sankisuguya-create/stl-box/README.md

# stl-box

3Dプリンタ（Bambu P1S）用STL置き場。

- [magnet-sphere/](magnet-sphere/) — 磁石で断面が吸着する分割球体（Ø150本番・Ø50モック・Ø200大版）
