sankisuguya-create/stl-box/magnet-sphere/sphere50/preview_hemisphere.png

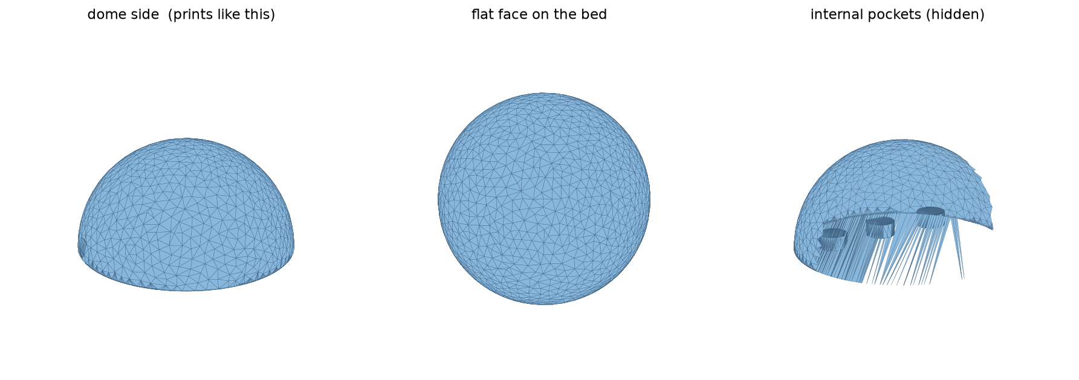
magnet-sphere/sphere50/preview_hemisphere.png
