sankisuguya-create/stl-box/magnet-sphere/sphere50/preview_layout.png

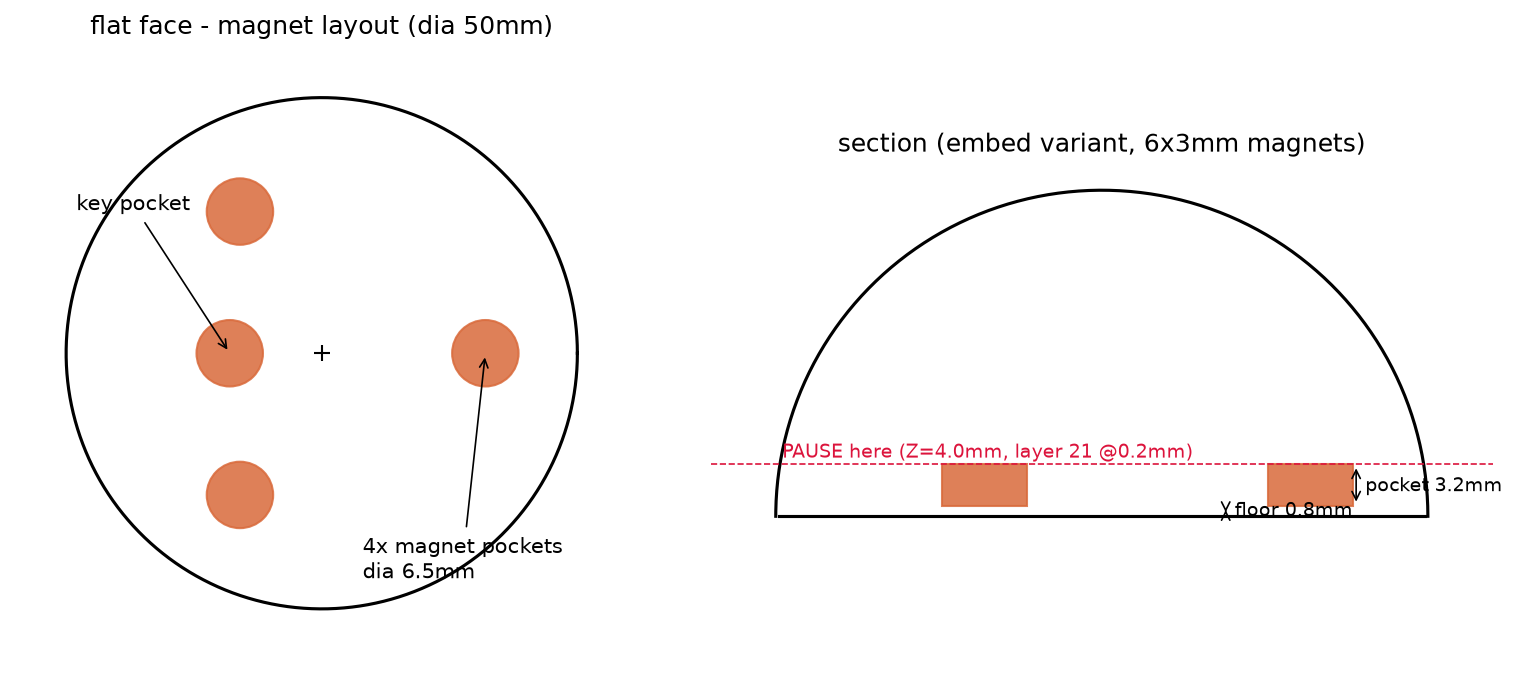
magnet-sphere/sphere50/preview_layout.png
