sankisuguya-create/stl-box/magnet-sphere/sphere150/preview150_exploded.png

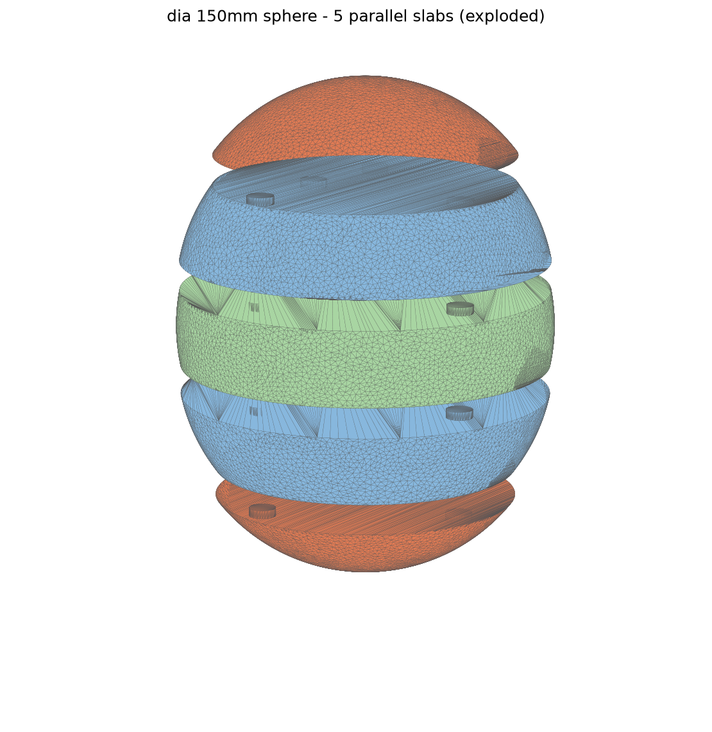
magnet-sphere/sphere150/preview150_exploded.png
