sankisuguya-create/stl-box/magnet-sphere/sphere150/sphere150_cap_m10x3_openface.stl

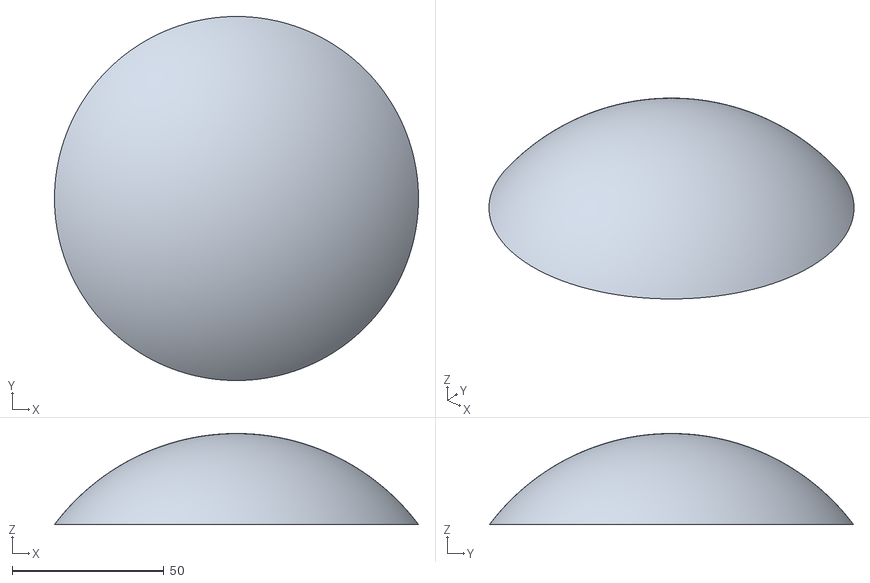
[picture p4: CAD file, 2026-10-11]
magnet-sphere/sphere150/sphere150_cap_m10x3_openface.stl
120.0 x 120.0 x 30.0
