sankisuguya-create/stl-box/magnet-sphere/sphere200/sphere200_cap_m10x3_openface.stl

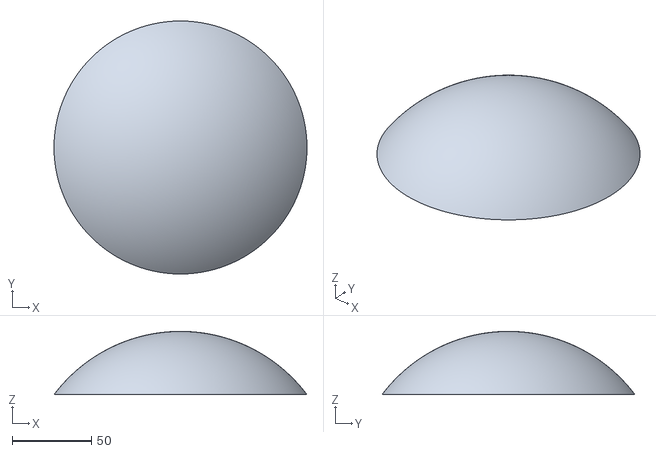
[picture p6: CAD file, 2026-10-11]
magnet-sphere/sphere200/sphere200_cap_m10x3_openface.stl
160.0 x 160.0 x 40.0
