sankisuguya-create/stl-box/magnet-sphere/sphere50/hemisphere50_m6x3_openface.stl

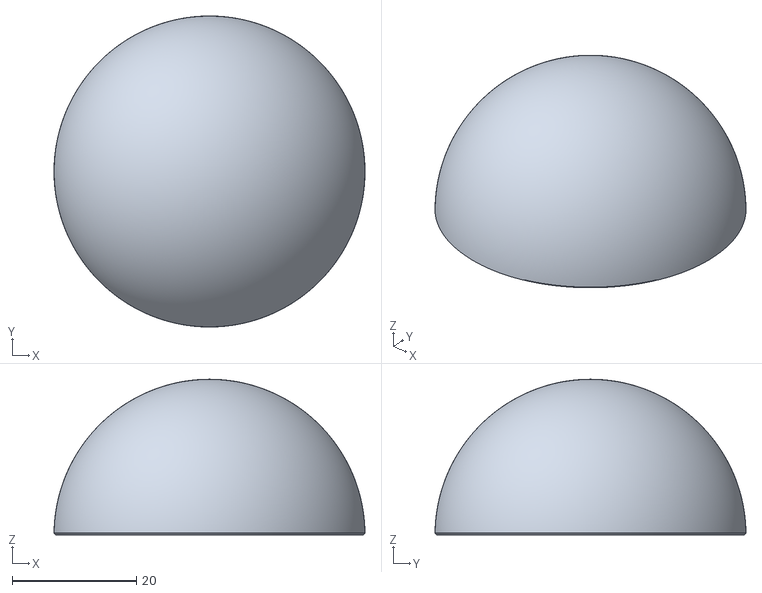
[picture p7: CAD file, 2026-10-11]
magnet-sphere/sphere50/hemisphere50_m6x3_openface.stl
50.0 x 50.0 x 25.0
