sankisuguya-create/stl-box/magnet-sphere/sphere150/sphere150_mid_slab_m10x3_embed.stl

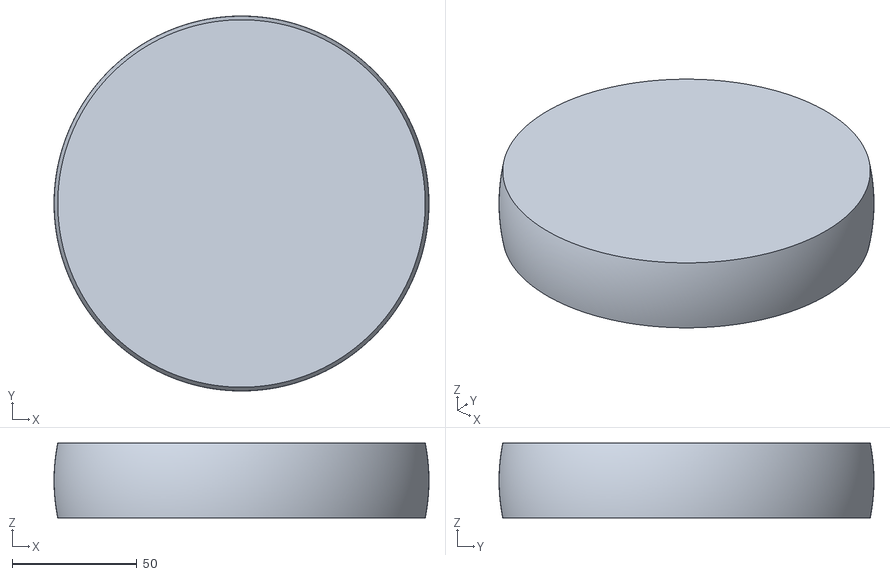
[picture p8: CAD file, 2026-10-11]
magnet-sphere/sphere150/sphere150_mid_slab_m10x3_embed.stl
150.0 x 150.0 x 30.0
