sankisuguya-create/stl-box/magnet-sphere/sphere150_cut5/sphere150cut5_P5_m10x3_embed.stl

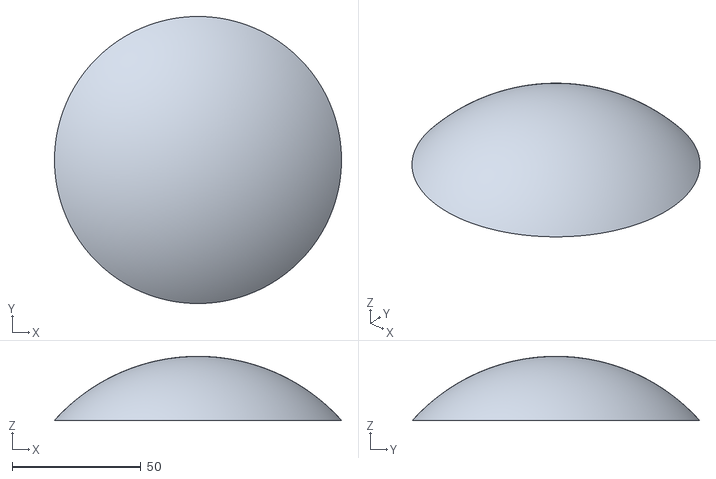
[picture p9: CAD file, 2026-10-11]
magnet-sphere/sphere150_cut5/sphere150cut5_P5_m10x3_embed.stl
111.5 x 111.5 x 25.0
