sankisuguya-create/stl-box/magnet-sphere/sphere200/sphere200_mid_slab_m10x3_embed.stl

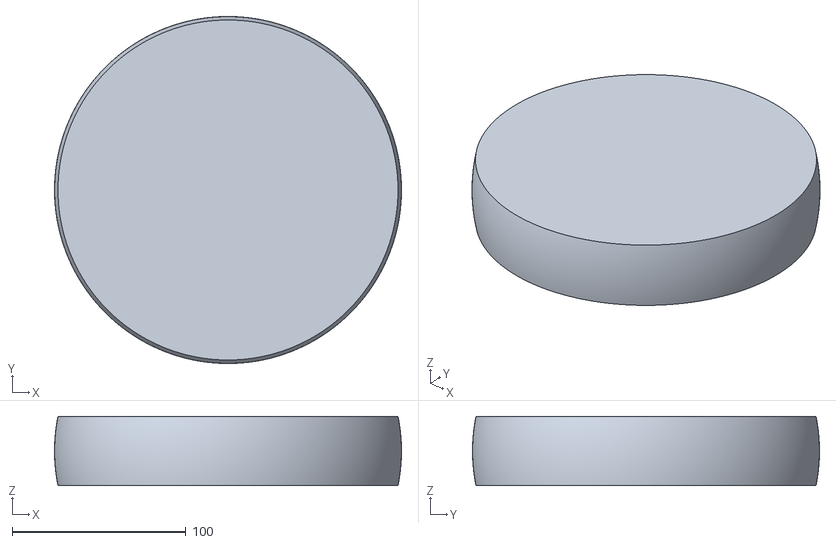
[picture p10: CAD file, 2026-10-11]
magnet-sphere/sphere200/sphere200_mid_slab_m10x3_embed.stl
200.0 x 200.0 x 40.0
