sankisuguya-create/stl-box/magnet-sphere/sphere50/hemisphere50_m5x2_embed.stl

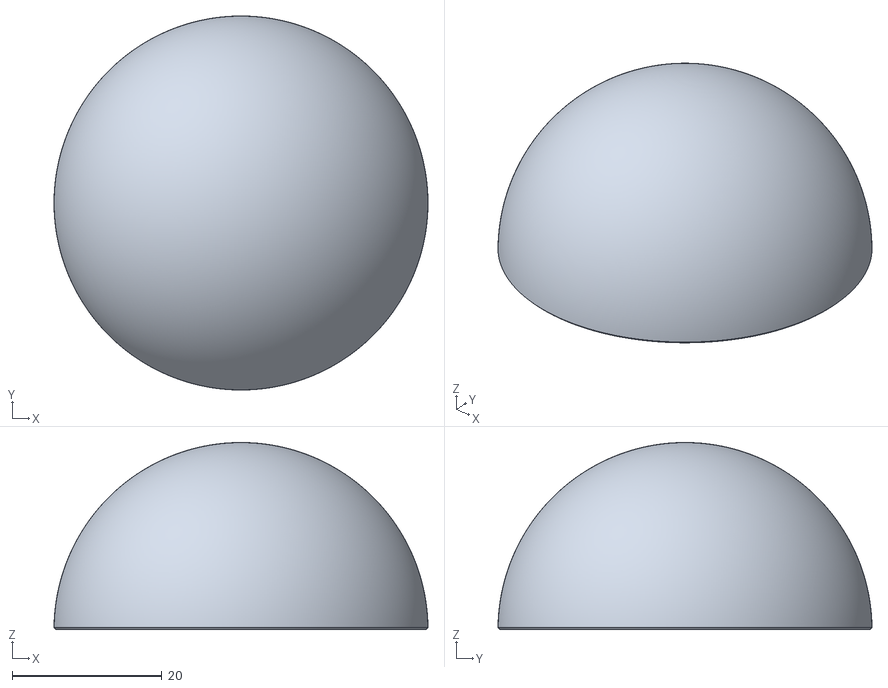
[picture p11: CAD file, 2026-10-09]
magnet-sphere/sphere50/hemisphere50_m5x2_embed.stl
50.0 x 50.0 x 25.0
