sankisuguya-create/stl-box/magnet-sphere/sphere150/sphere150_edge_slab_m10x3_embed.stl

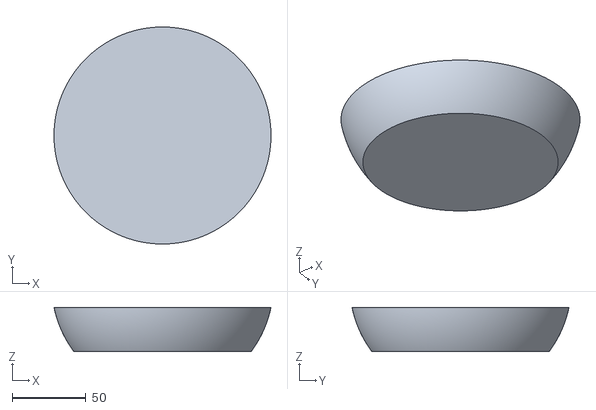
[picture p12: CAD file, 2026-10-11]
magnet-sphere/sphere150/sphere150_edge_slab_m10x3_embed.stl
147.0 x 147.0 x 30.0
