sankisuguya-create/stl-box/magnet-sphere/sphere150_cut5/sphere150cut5_P1_m10x3_embed.stl

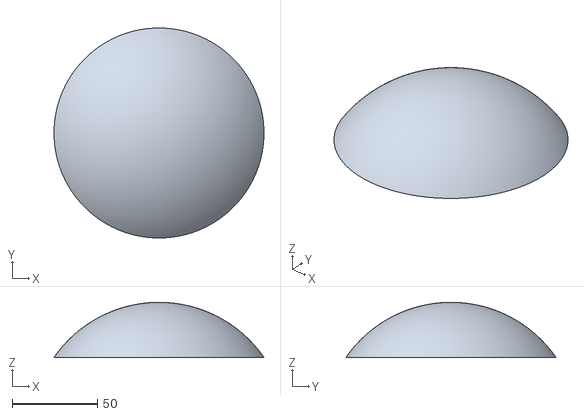
[picture p13: CAD file, 2026-10-11]
magnet-sphere/sphere150_cut5/sphere150cut5_P1_m10x3_embed.stl
123.3 x 123.3 x 32.5
