sankisuguya-create/stl-box/magnet-sphere/sphere50/hemisphere50_m10x3_embed.stl

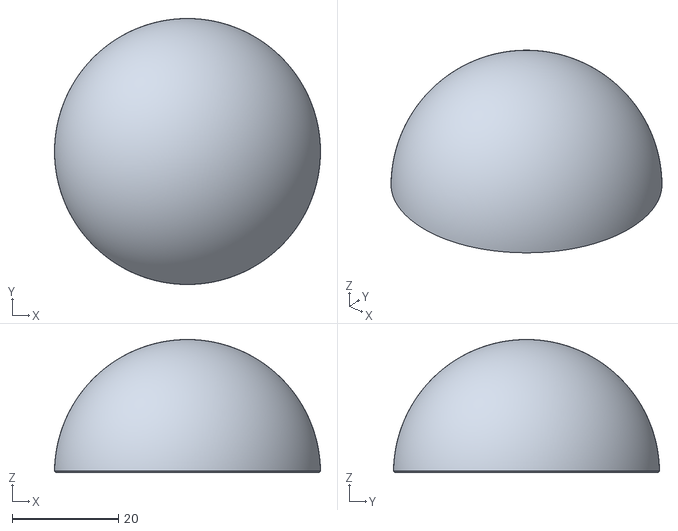
[picture p14: CAD file, 2026-10-09]
magnet-sphere/sphere50/hemisphere50_m10x3_embed.stl
50.0 x 50.0 x 25.0
