sankisuguya-create/stl-box/magnet-sphere/sphere150/sphere150_cap_m10x3_embed.stl

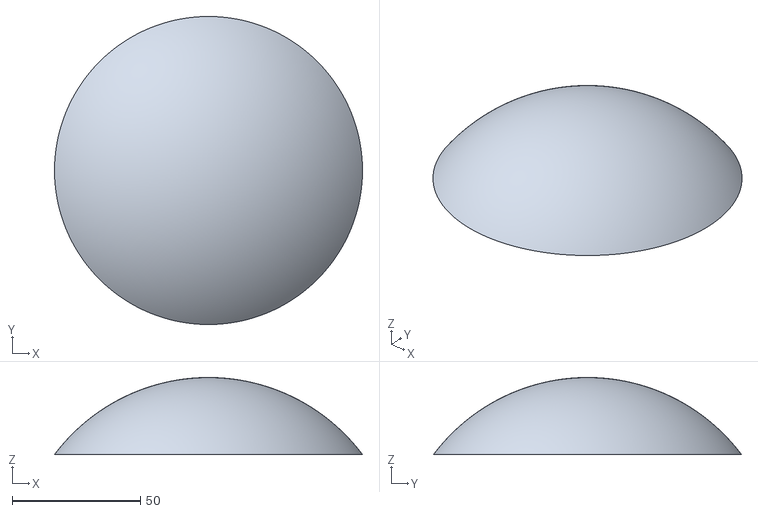
[picture p15: CAD file, 2026-10-09]
magnet-sphere/sphere150/sphere150_cap_m10x3_embed.stl
120.0 x 120.0 x 30.0
