sankisuguya-create/stl-box/magnet-sphere/sphere150_cut5/sphere150cut5_P2_m10x3_embed.stl

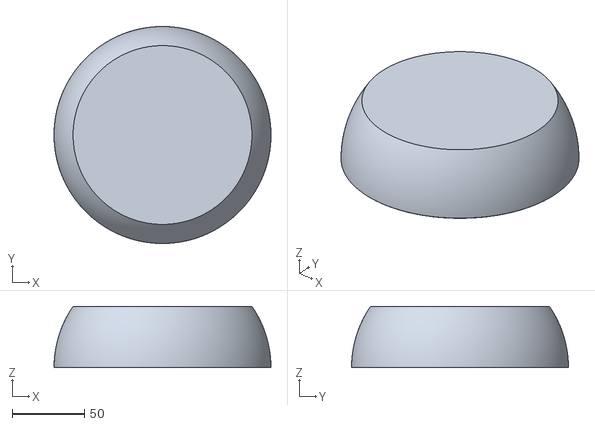
[picture p16: CAD file, 2026-10-11]
magnet-sphere/sphere150_cut5/sphere150cut5_P2_m10x3_embed.stl
150.0 x 150.0 x 42.5
