sankisuguya-create/stl-box/magnet-sphere/sphere200/sphere200_mid_slab_m10x3_openface.stl

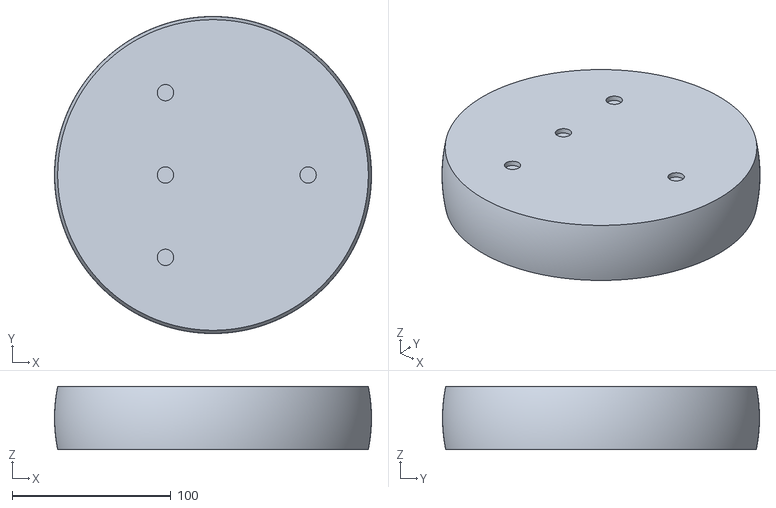
[picture p17: CAD file, 2026-10-09]
magnet-sphere/sphere200/sphere200_mid_slab_m10x3_openface.stl
200.0 x 200.0 x 40.0
