sankisuguya-create/stl-box/magnet-sphere/sphere150/sphere150_mid_slab_m10x3_openface.stl

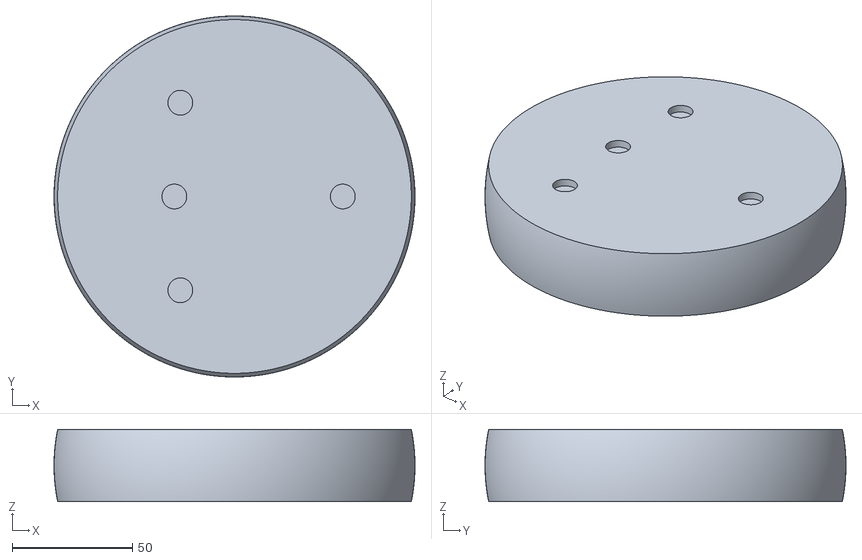
[picture p19: CAD file, 2026-10-09]
magnet-sphere/sphere150/sphere150_mid_slab_m10x3_openface.stl
150.0 x 150.0 x 30.0
