sankisuguya-create/stl-box/magnet-sphere/sphere150_cut5/sphere150cut5_P4_m10x3_embed.stl

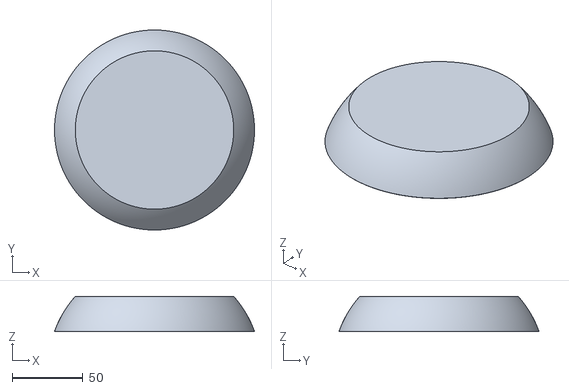
[picture p20: CAD file, 2026-10-11]
magnet-sphere/sphere150_cut5/sphere150cut5_P4_m10x3_embed.stl
141.3 x 141.3 x 25.0
