sankisuguya-create/stl-box/magnet-sphere/sphere150/sphere150_edge_slab_m10x3_openface.stl

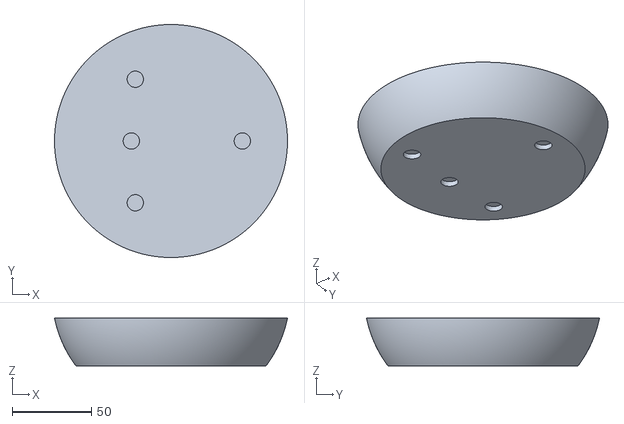
[picture p23: CAD file, 2026-10-09]
magnet-sphere/sphere150/sphere150_edge_slab_m10x3_openface.stl
147.0 x 147.0 x 30.0
