sankisuguya-create/stl-box/magnet-sphere/sphere200/sphere200_edge_slab_m10x3_embed.stl

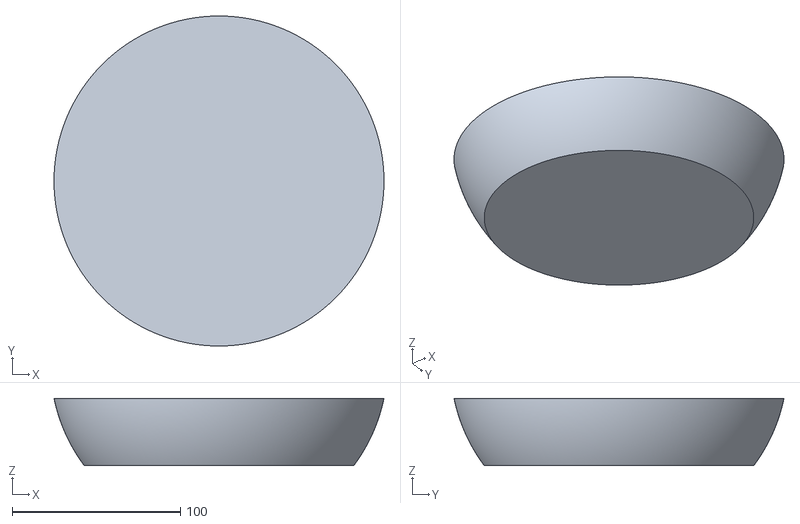
[picture p24: CAD file, 2026-10-09]
magnet-sphere/sphere200/sphere200_edge_slab_m10x3_embed.stl
196.0 x 196.0 x 40.0
