sankisuguya-create/stl-box/(list of files, cad)

Other CAD files:
magnet-sphere/sphere200/sphere200_cap_m10x3_embed.stl
