sankisuguya-create/stl-box/(commit log)

2026-10-09 magnet-sphere: 磁石吸着式分割球体STL（Ø150本番5層・Ø50モック・Ø200大版＋ガイド・生成スクリプト）
    [hemisphere50_m10x3_embed.stl, hemisphere50_m5x2_embed.stl, hemisphere50_m6x3_embed.stl, hemisphere50_m6x3_openface.stl, hemisphere50_m8x3_embed.stl, sphere150_cap_m10x3_embed.stl, sphere150_cap_m10x3_openface.stl, sphere150_edge_slab_m10x3_embed.stl]
2026-10-09 magnet-sphere: レビュー指摘の修正（一時停止層・向き記述・重量・プレート・生成スクリプト統合）
    - 一時停止の層番号をやめ、プレビューで穴が消える層の直前を指定する手順に変更
    - 「合い印で1通りの向きでしか閉じない」の誤記述を削除
    - 推定重量を概算に修正し、スライサーで確定させる旨を追記
    - Ø150/Ø200 ガイドにスムースPEI推奨を追記
    - gen_sphere150/200.py を gen_slab_sphere.py に統合、出力先をリポジトリ内に変更
    （再生成したSTLは既存と体積・面数一致を確認、STLは変更なし）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
2026-10-09 magnet-sphere: Bambu Studio操作を含む利用者向け手順書を追加
    Claude-Session: https://claude.ai/code/session_017iuESQcn3NYVorUgMgxLyB
2026-10-11 magnet-sphere: 磁石ポケットを90°等配（点対称）に変更しSTLを再生成
    合い印配置（3等配＋内側1）は全4組が揃う角度が1か所しかなく、
    合わせる手間が増えるだけだったため、同一円周上の90°等配4個に変更。
    磁石数・極のルールは変更なし。
    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
2026-10-11 magnet-sphere: Ø150 切れ目指定版（上から32.5/75/100/125mm・5分割）を追加
    - gen_cut_sphere.py：任意の高さで切る生成スクリプト。全パーツを大きい断面を下にして出力（オーバーハングなし）
    - ポケットは断面ごとに円の半径を決め、球面まで肉厚4mm以上を確保
    - 埋め込み式を標準とし、この版は embed のみ生成
    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
2026-10-11 magnet-sphere: Ø150 5分割版の各断面中心に磁石ポケットを追加（任意で使用）
    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
2026-10-12 magnet-sphere: Ø150 5分割版の赤道面（P2/P3）を磁石8個配置に変更
    外側r=65に東西南北4個＋内側r=40に北東・南東・南西・北西4個、中心なし。
    他の断面は現行どおり（4個＋中心1個）。
    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
2026-10-16 magnet-sphere: 磁力の基準（赤道面8組で適正）と磁力計算スクリプトを追加
    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
2026-10-16 magnet-sphere: 基準磁石の等級をN35と記入
    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
